Remy495/AMPED_UP/Website/Images/mechanical1.png

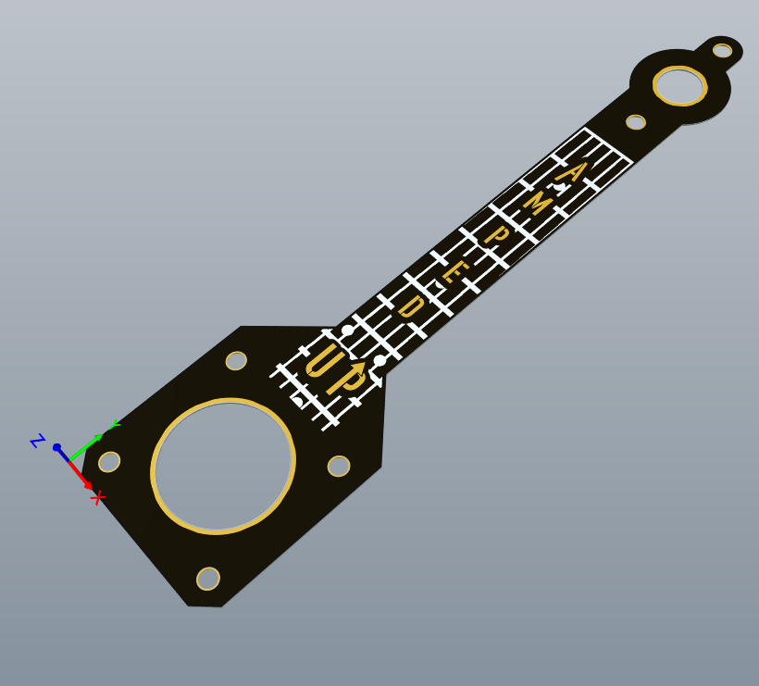
Website/Images/mechanical1.png
