Remy495/AMPED_UP/Website/Images/mechanical2.png

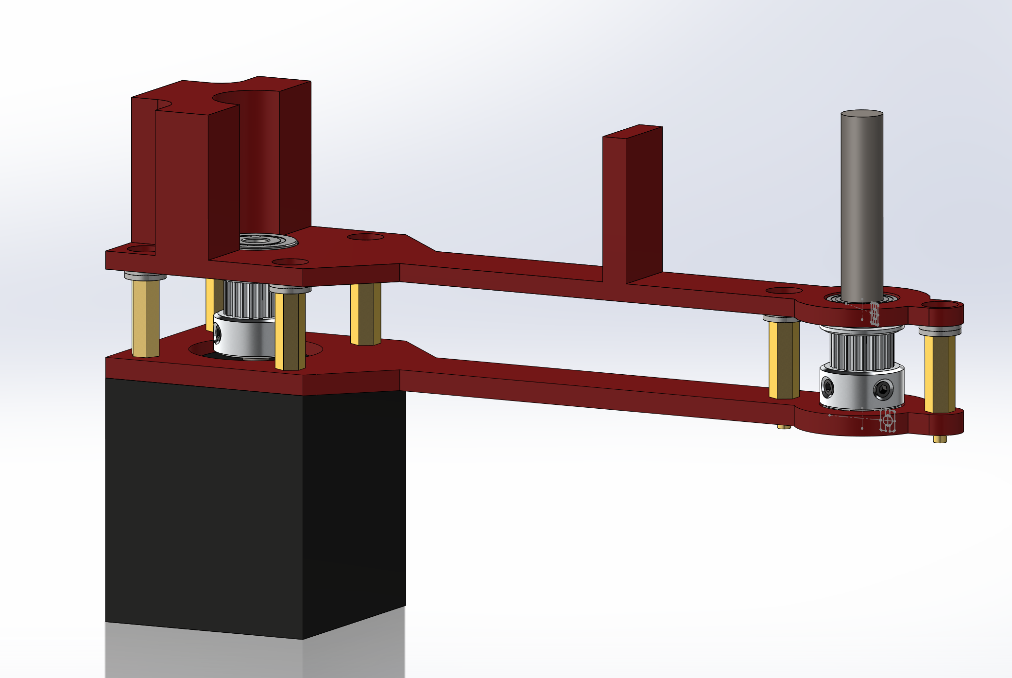
Website/Images/mechanical2.png
