Remy495/AMPED_UP/Website/Images/Aaron.jpg

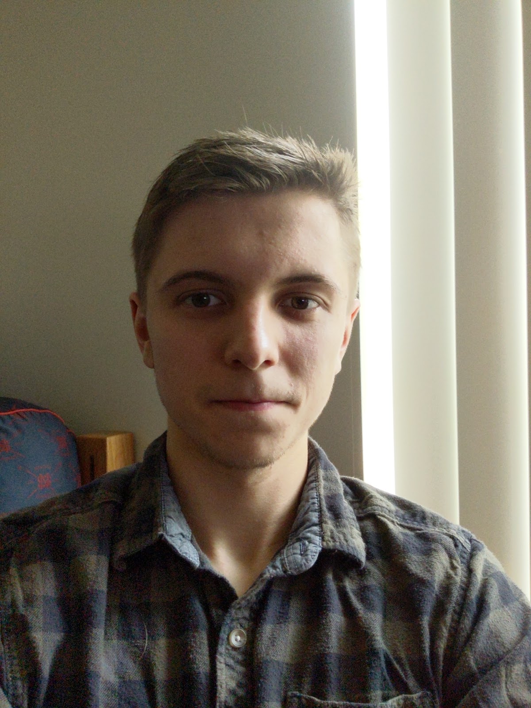
Website/Images/Aaron.jpg
