Remy495/AMPED_UP/Website/Images/Casey.jpg

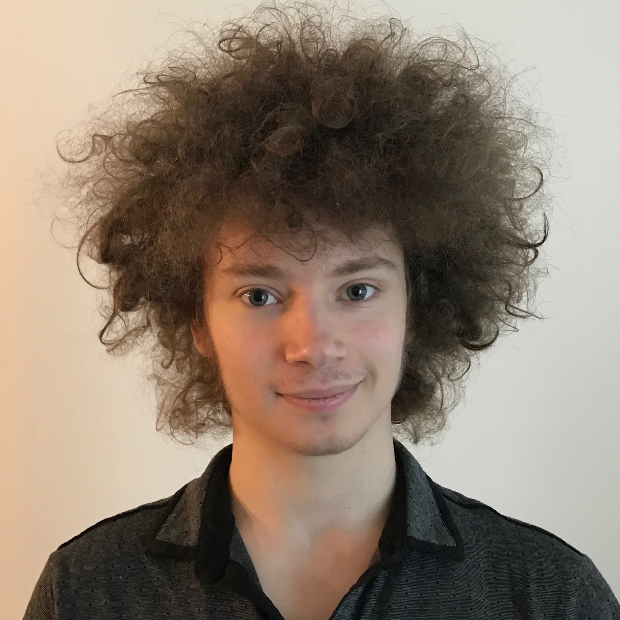
Website/Images/Casey.jpg
