Remy495/AMPED_UP/Website/Images/Chris.png

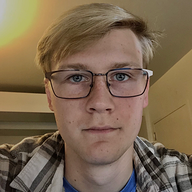
Website/Images/Chris.png
