Remy495/AMPED_UP/Website/Images/Design_Diagram.png

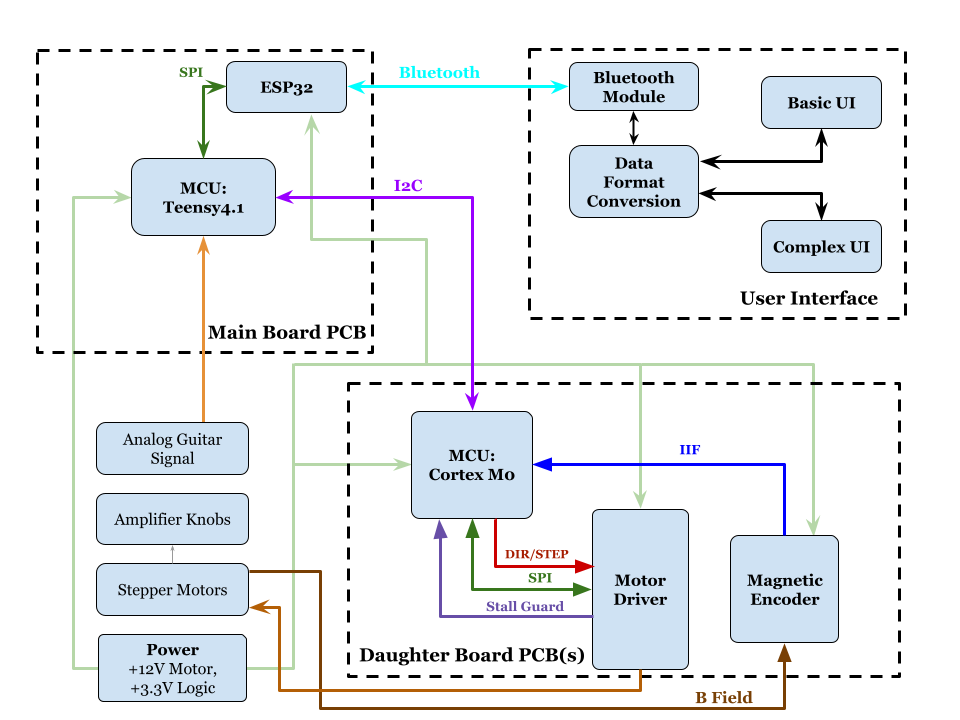
Website/Images/Design_Diagram.png
