Remy495/AMPED_UP/Website/Images/Mainboard.png

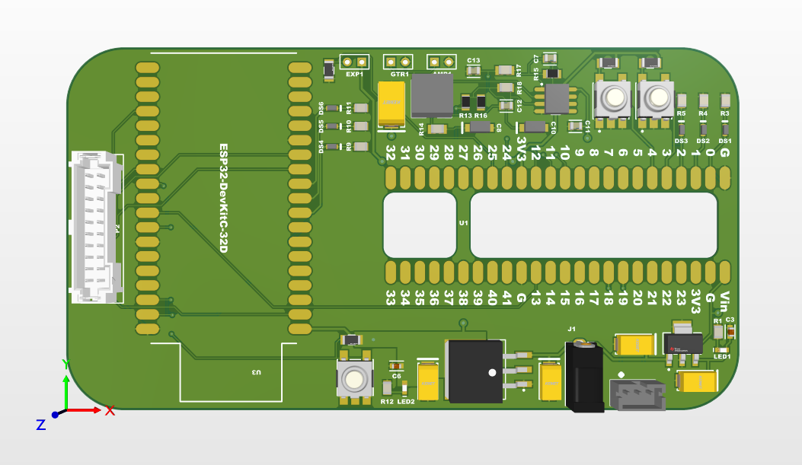
Website/Images/Mainboard.png
