Remy495/AMPED_UP/Website/Images/mechanical3.png

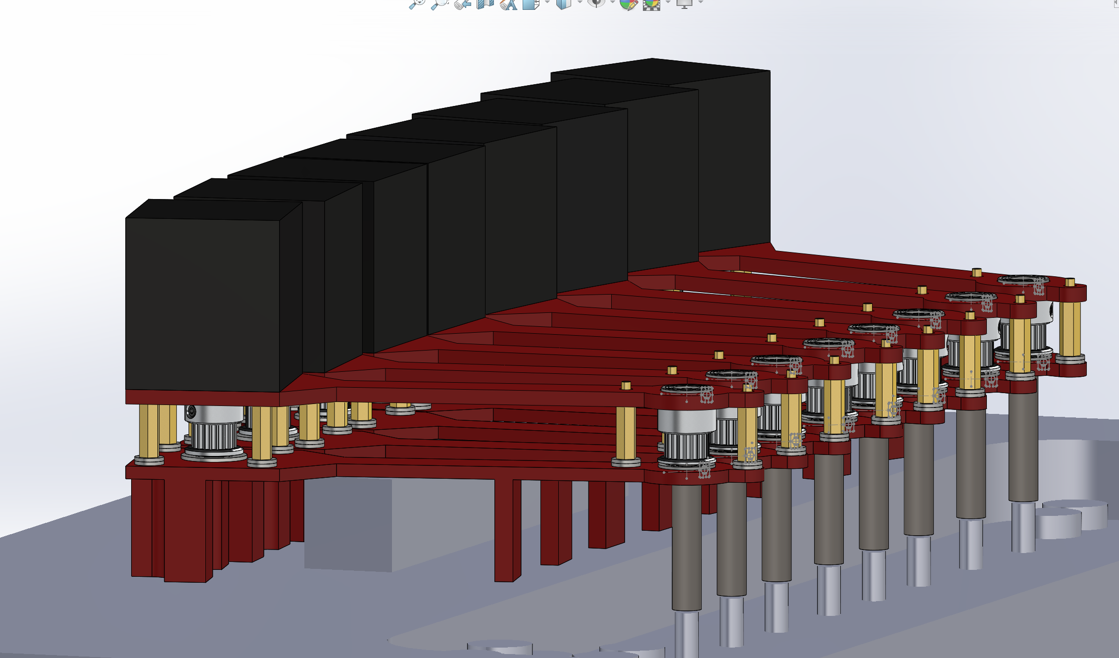
Website/Images/mechanical3.png
