Remy495/AMPED_UP/Website/Images/medium-ATSAMD21E15-TQFP-32.png

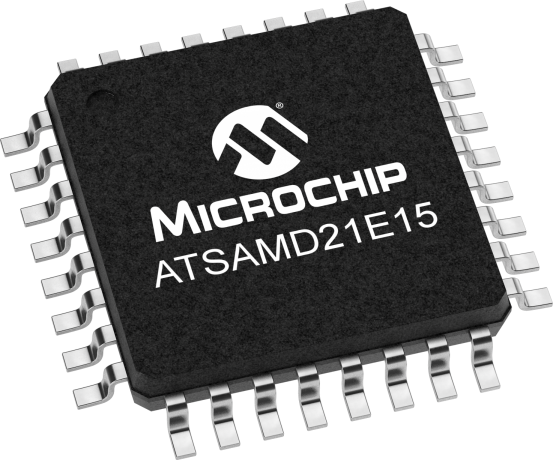
Website/Images/medium-ATSAMD21E15-TQFP-32.png
