Remy495/AMPED_UP/Website/Images/Remy.jpg

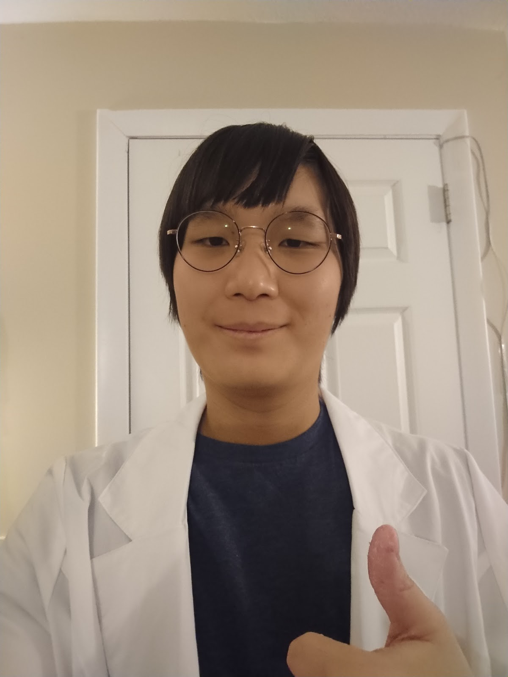
Website/Images/Remy.jpg
