Remy495/AMPED_UP/Website/Images/TLE5012B.jpg

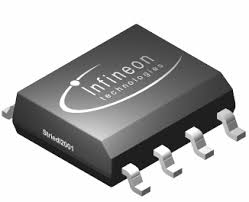
Website/Images/TLE5012B.jpg
