Remy495/AMPED_UP/Website/Images/TMC2130.jpg

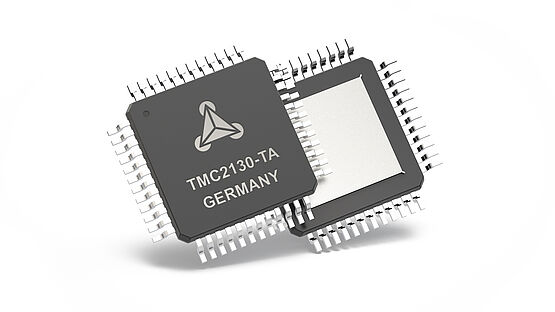
Website/Images/TMC2130.jpg
