Remy495/AMPED_UP/Website/Images/wolf.jpg

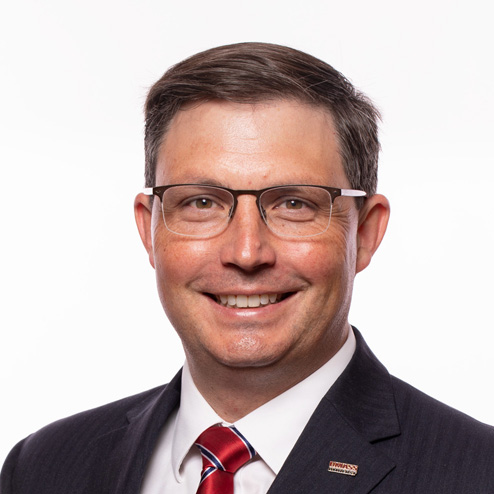
Website/Images/wolf.jpg
