Remy495/AMPED_UP/Altium/SDP21_Main_Board/SDP21_Main_Board_PCB.step

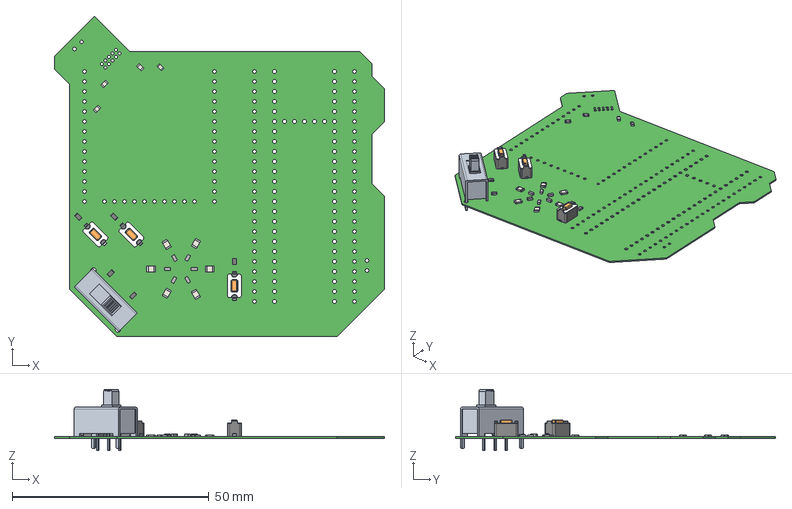
[picture p14: CAD file, 2020-11-20, an earlier design]
Altium/SDP21_Main_Board/SDP21_Main_Board_PCB.step
83.8 x 81.3 x 15.5 mm
Extruded x 36
c-1825255-1-a-3d
Frame x 3
Cover x 3
pins x 6
Mid_Body x 5
Open_CASCADE_STEP_translator_6.8_3.2.1 x 10
Mark x 5
