Remy495/AMPED_UP/Altium/SDP21_Daughter_Board/Project Outputs for SDP21_Daughter_Board/Job1.PDF

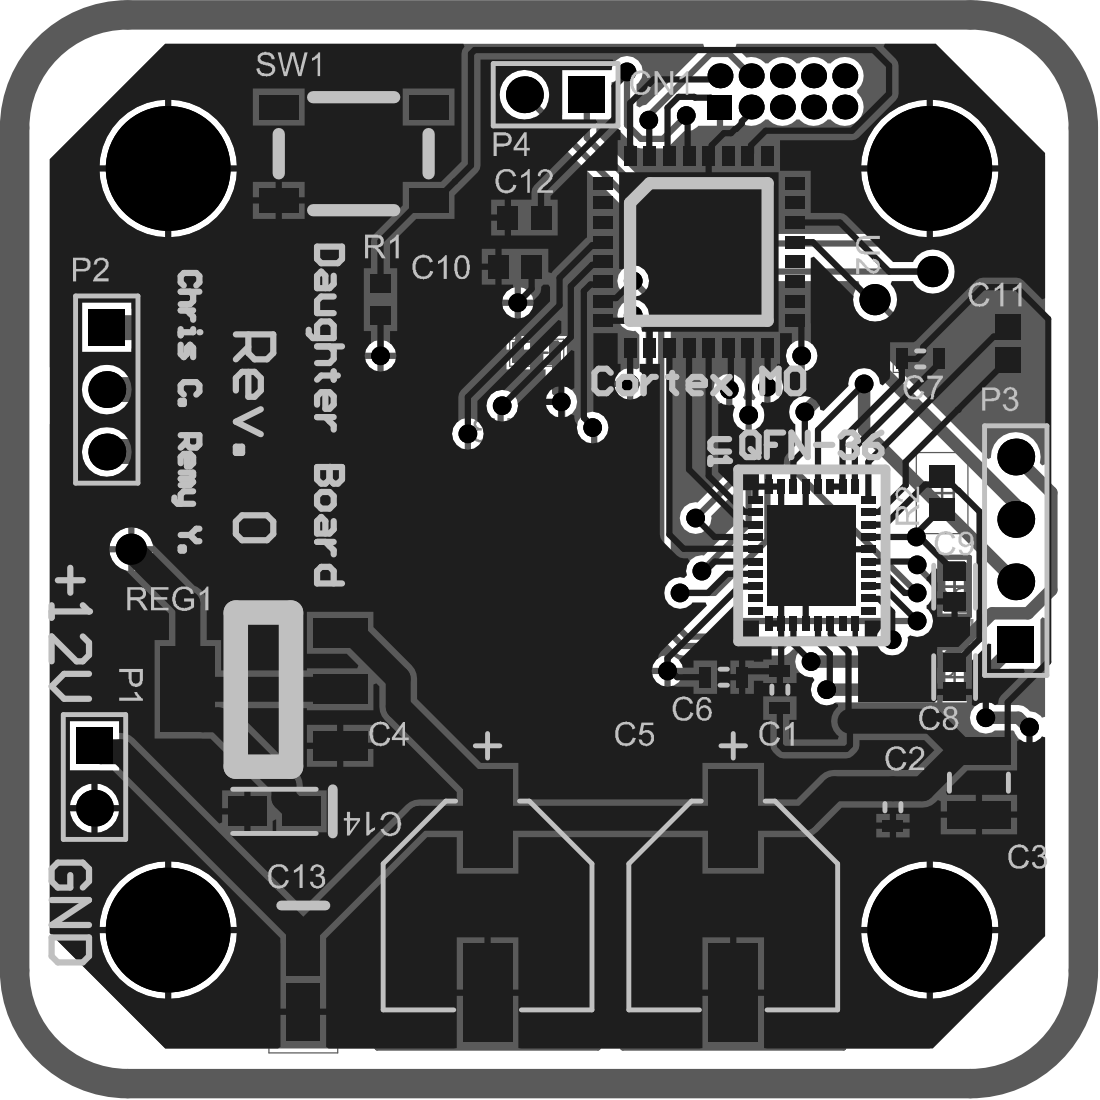
[picture p28: page 1]

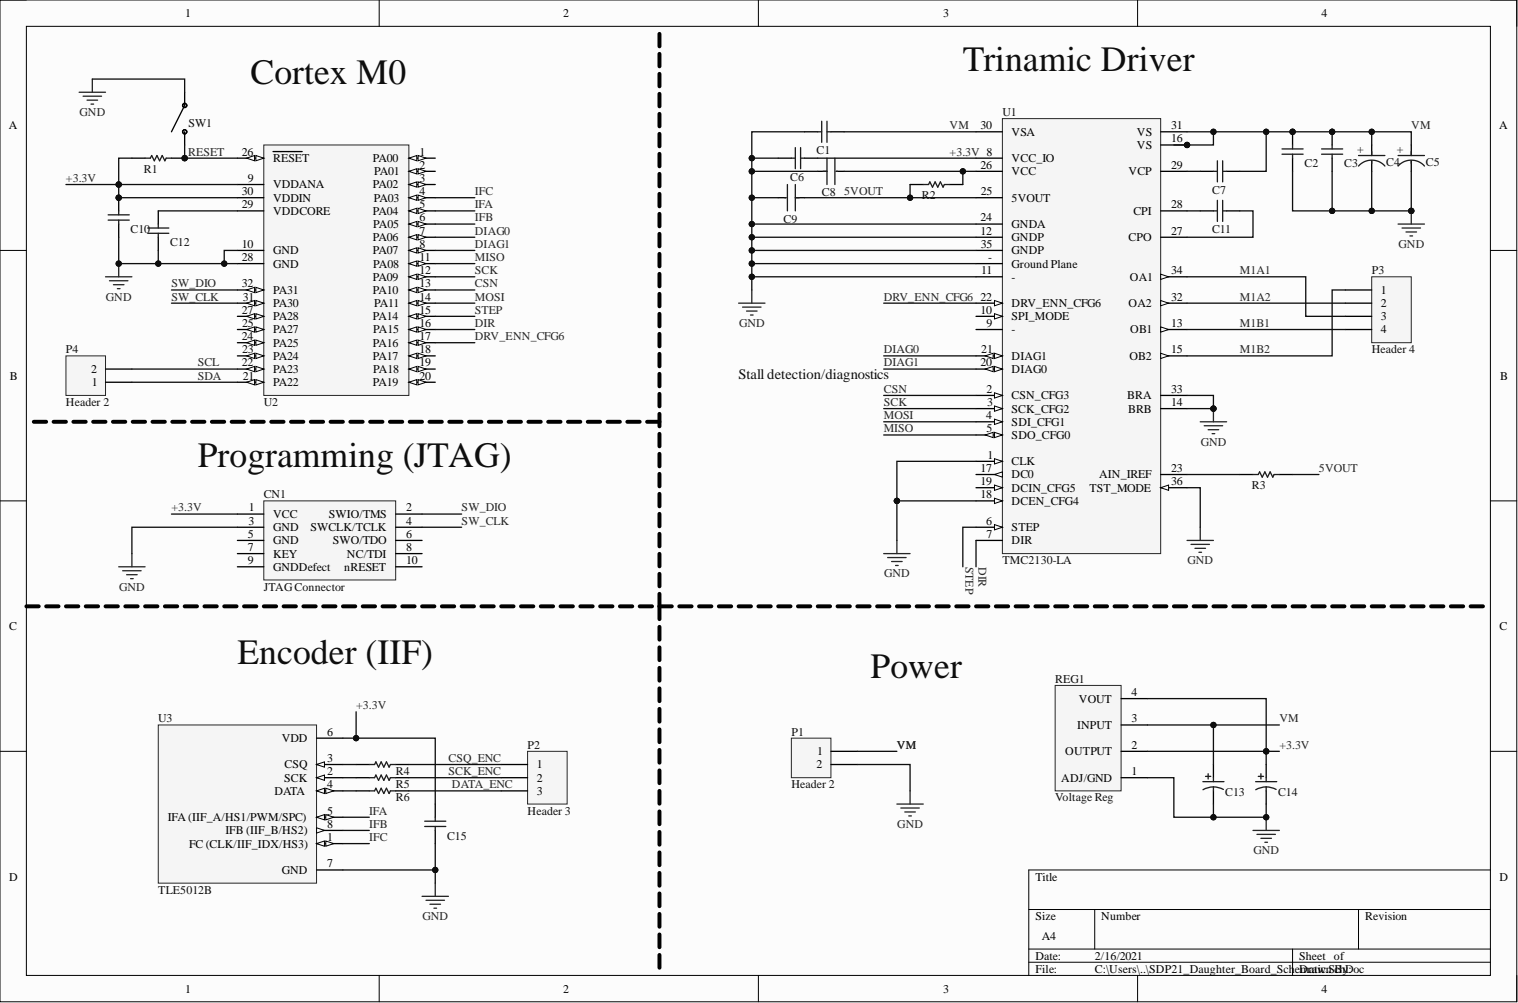
[picture p29: page 2]
