Remy495/AMPED_UP/(list of files, drawings)

Other design files:
Altium/Guitar_Input_Stage/Guitar Input PCB.PcbDoc
Altium/Guitar_Input_Stage/Guitar Input Schematic.SchDoc
Altium/Guitar_Input_Stage/SDP21_Guitar_Input_Stage.PrjPcb
Altium/Mechanical System/Mechanical Plates.PcbDoc
Altium/Mechanical System/Mechanical System.PrjPcb
Altium/PCB_Project/PCB_Project.PrjPcb
Altium/SDP21_Daughter_Board_REV1/Daughter_Board_PCB_Layout_REV1.PcbDoc
Altium/SDP21_Daughter_Board_REV1/SDP21_Daughter_Board_REV1.PrjPcb
Altium/SDP21_Daughter_Board_REV1/SDP21_Daughter_Board_Schematic_REV1.SchDoc
Altium/SDP21_Daughter_Board_REV1/SDP21_Footprints_REV1.PcbLib
Altium/SDP21_Daughter_Board_REV1/SDP21_Symbols_REV1.SchLib
Altium/SDP21_Guitar_Input_Stage/SDP21_Guitar Input PCB.PcbDoc
Altium/SDP21_Guitar_Input_Stage/SDP21_Guitar Input Schematic.SchDoc
Altium/SDP21_Guitar_Input_Stage/SDP21_Guitar_Input_Stage.PrjPcb
Altium/SDP21_Main_Board/SDP21_Daughter_Board_Footprints.PcbLib
Altium/SDP21_Main_Board/SDP21_Daughter_Board_Symbols.SchLib
Altium/SDP21_Main_Board/SDP21_Main_Board.PrjPcb
Altium/SDP21_Main_Board/SDP21_Main_Board_PCB.PcbDoc
Altium/SDP21_Main_Board/SDP21_Main_Board_PCB_Library.PcbLib
Altium/SDP21_Main_Board/SDP21_Main_Board_Schematic_Library.SchLib
Altium/SDP21_Main_Board_REV1/Main_Board_ESP32.SchDoc
Altium/SDP21_Main_Board_REV1/Main_Board_Guitar_Buffer.SchDoc
Altium/SDP21_Main_Board_REV1/Main_Board_IO.SchDoc
Altium/SDP21_Main_Board_REV1/Main_Board_PCB.PcbDoc
Altium/SDP21_Main_Board_REV1/Main_Board_Teensy.SchDoc
Altium/SDP21_Main_Board_REV1/SDP21_Main_Board_REV1.PrjPcb
Altium/SDP21_Trinamic_Driver_Board/SDP21_Footprints.PcbLib
Altium/SDP21_Trinamic_Driver_Board/SDP21_Trinamic_Driver_Board.PrjPcb
Altium/SDP21_Trinamic_Driver_Board/Trinamic Driver PCB.PcbDoc
Altium/SDP21_Trinamic_Driver_Board/Trinamic Driver Schematic.SchDoc
