Remy495/AMPED_UP/Hardware/Esp32/SpiRelay/main/main.cpp

/*
 * Copyright (C) 2020 BlueKitchen GmbH
 *
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
 * 1. Redistributions of source code must retain the above copyright
 *    notice, this list of conditions and the following disclaimer.
 * 2. Redistributions in binary form must reproduce the above copyright
 *    notice, this list of conditions and the following disclaimer in the
 *    documentation and/or other materials provided with the distribution.
 * 3. Neither the name of the copyright holders nor the names of
 *    contributors may be used to endorse or promote products derived
 *    from this software without specific prior written permission.
 *
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
 */

/*
 *  main.c
 *
 *  Minimal main application that initializes BTstack, prepares the example and enters BTstack's Run Loop.
 *
 *  If needed, you can create other threads. Please note that BTstack's API is not thread-safe and can only be
 *  called from BTstack timers or in response to its callbacks, e.g. packet handlers.
 */

#include "freertos/FreeRTOS.h"
#include "freertos/task.h"
#include "btstack_port_esp32.h"
#include "btstack_run_loop.h"
#include "hci_dump.h"

#include "BluetoothManager.hpp"
#include "SpiManager.hpp"

#include "CircularQueue.hpp"

#include <cstdio>
#include <iostream>
#include <stddef.h>

void runSpiManager(void*)
{
    if (!AmpedUp::SpiManager::run(GPIO_NUM_23, GPIO_NUM_19, GPIO_NUM_18, GPIO_NUM_22, GPIO_NUM_33))
    {
        printf("Error occured in SPI manager\n");
    }
}

TaskHandle_t spiTaskHandle = 0;

extern "C" int app_main(void){


    // Start SPI manager
    xTaskCreate(runSpiManager, "SpiManagerTask", 10240, nullptr, tskIDLE_PRIORITY, &spiTaskHandle);
    // Start Bluetooth manager
    AmpedUp::BluetoothManager::run();

    return 0;
}
