Remy495/AMPED_UP/Hardware/Cortex/C/M0_Motor_Test/driver_init.c

/*
 * Code generated from Atmel Start.
 *
 * This file will be overwritten when reconfiguring your Atmel Start project.
 * Please copy examples or other code you want to keep to a separate file
 * to avoid losing it when reconfiguring.
 */

#include "driver_init.h"
#include <peripheral_clk_config.h>
#include <utils.h>
#include <hal_init.h>
#include <hpl_gclk_base.h>
#include <hpl_pm_base.h>

#include <hpl_rtc_base.h>

struct spi_m_sync_descriptor SPI_0;
struct timer_descriptor      TIMER_0;

struct i2c_m_sync_desc I2C_0;

void SPI_0_PORT_init(void)
{

	// Set pin direction to input
	gpio_set_pin_direction(PA08, GPIO_DIRECTION_IN);

	gpio_set_pin_pull_mode(PA08,
	                       // <y> Pull configuration
	                       // <id> pad_pull_config
	                       // <GPIO_PULL_OFF"> Off
	                       // <GPIO_PULL_UP"> Pull-up
	                       // <GPIO_PULL_DOWN"> Pull-down
	                       GPIO_PULL_OFF);

	gpio_set_pin_function(PA08, PINMUX_PA08C_SERCOM0_PAD0);

	gpio_set_pin_level(PA09,
	                   // <y> Initial level
	                   // <id> pad_initial_level
	                   // <false"> Low
	                   // <true"> High
	                   false);

	// Set pin direction to output
	gpio_set_pin_direction(PA09, GPIO_DIRECTION_OUT);

	gpio_set_pin_function(PA09, PINMUX_PA09C_SERCOM0_PAD1);

	gpio_set_pin_level(PA11,
	                   // <y> Initial level
	                   // <id> pad_initial_level
	                   // <false"> Low
	                   // <true"> High
	                   false);

	// Set pin direction to output
	gpio_set_pin_direction(PA11, GPIO_DIRECTION_OUT);

	gpio_set_pin_function(PA11, PINMUX_PA11C_SERCOM0_PAD3);
}

void SPI_0_CLOCK_init(void)
{
	_pm_enable_bus_clock(PM_BUS_APBC, SERCOM0);
	_gclk_enable_channel(SERCOM0_GCLK_ID_CORE, CONF_GCLK_SERCOM0_CORE_SRC);
}

void SPI_0_init(void)
{
	SPI_0_CLOCK_init();
	spi_m_sync_init(&SPI_0, SERCOM0);
	spi_m_sync_set_mode(&SPI_0, SPI_MODE_3);
	SPI_0_PORT_init();
}

void I2C_0_PORT_init(void)
{

	gpio_set_pin_pull_mode(PA22,
	                       // <y> Pull configuration
	                       // <id> pad_pull_config
	                       // <GPIO_PULL_OFF"> Off
	                       // <GPIO_PULL_UP"> Pull-up
	                       // <GPIO_PULL_DOWN"> Pull-down
	                       GPIO_PULL_OFF);

	gpio_set_pin_function(PA22, PINMUX_PA22C_SERCOM3_PAD0);

	gpio_set_pin_pull_mode(PA23,
	                       // <y> Pull configuration
	                       // <id> pad_pull_config
	                       // <GPIO_PULL_OFF"> Off
	                       // <GPIO_PULL_UP"> Pull-up
	                       // <GPIO_PULL_DOWN"> Pull-down
	                       GPIO_PULL_OFF);

	gpio_set_pin_function(PA23, PINMUX_PA23C_SERCOM3_PAD1);
}

void I2C_0_CLOCK_init(void)
{
	_pm_enable_bus_clock(PM_BUS_APBC, SERCOM3);
	_gclk_enable_channel(SERCOM3_GCLK_ID_CORE, CONF_GCLK_SERCOM3_CORE_SRC);
	_gclk_enable_channel(SERCOM3_GCLK_ID_SLOW, CONF_GCLK_SERCOM3_SLOW_SRC);
}

void I2C_0_init(void)
{
	I2C_0_CLOCK_init();
	i2c_m_sync_init(&I2C_0, SERCOM3);
	I2C_0_PORT_init();
}

/**
 * \brief Timer initialization function
 *
 * Enables Timer peripheral, clocks and initializes Timer driver
 */
static void TIMER_0_init(void)
{
	_pm_enable_bus_clock(PM_BUS_APBA, RTC);
	_gclk_enable_channel(RTC_GCLK_ID, CONF_GCLK_RTC_SRC);
	timer_init(&TIMER_0, RTC, _rtc_get_timer());
}

void system_init(void)
{
	init_mcu();

	SPI_0_init();

	I2C_0_init();

	TIMER_0_init();
}
