Remy495/AMPED_UP/(commit log)

2020-10-12 Project Begin
    Created first project docs
    [SDP21_Daughter_Board.PrjPcb, SDP21_Daughter_Board_Schematic.SchDoc, SDP21_Footprints.PcbLib, SDP21_Symbols.SchLib]
2020-10-13 Added Symbols and Footprints
    Added custom footprints and symbols for encoder, stepper driver and Cortex M0 MCU
    [SDP21_Footprints.PcbLib, SDP21_Symbols.SchLib]
2020-10-13 Continued Work
    Need to add schematic elements with appropriate supposrting hardware before connecting encoder and driver to MCU
    [SDP21_Daughter_Board_Schematic.SchDoc, SDP21_Symbols.SchLib]
2020-10-14 Finished .Preparing TMC
    yeah.
    [SDP21_Daughter_Board_Schematic.SchDoc]
2020-10-15 Continued Development
    [SDP21_Daughter_Board_Schematic.SchDoc, SDP21_Footprints.PcbLib, SDP21_Symbols.SchLib]
2020-10-16 progress
    made progress
    [SDP21_Daughter_Board_Schematic.SchDoc, SDP21_Footprints.PcbLib, SDP21_Symbols.SchLib]
2020-10-16 Progress
    ...
    [SDP21_Daughter_Board_Schematic.SchDoc]
2020-10-16 Testing something
    yeah
    [SDP21_Daughter_Board_Schematic.SchDoc]
2020-10-16 Guthub Testing
    ignore
    [SDP21_Daughter_Board_Schematic.SchDoc]
2020-10-16 Finished Com Lines
    Just need to wire the JTAG connector
    [SDP21_Footprints.PcbLib, SDP21_Symbols.SchLib]
2020-10-20 Fixed M0 Pin Connections
    Still need programmer and stuff
    [SDP21_Daughter_Board_Schematic.SchDoc]
2020-10-20 Preparing for Checkin
    Need to fix JTAG and also doble check connections before layout
    [SDP21_Daughter_Board_Schematic.SchDoc]
2020-10-20 Hey I made a PCB outline
    Lol this will be fun to route....
    [Daughter_Board_PCB_Layout.PcbDoc, SDP21_Daughter_Board.PrjPcb, SDP21_Daughter_Board_Schematic.SchDoc, SDP21_Symbols.SchLib]
2020-10-21 Crappy PCB Layout
    Needs a lot of work before routing can start. Why is R6 a different footprint??
    [Daughter_Board_PCB_Layout.PcbDoc, SDP21_Daughter_Board_Schematic.SchDoc]
2020-10-21 small changes
    I keep messing with it lol
    [Daughter_Board_PCB_Layout.PcbDoc]
2020-10-23 PCB part placement
    [Daughter_Board_PCB_Layout.PcbDoc, SDP21_Daughter_Board.PrjPcb, SDP21_Daughter_Board_Schematic.SchDoc]
2020-10-23 Routing begin.
    [Daughter_Board_PCB_Layout.PcbDoc, SDP21_Daughter_Board_Schematic.SchDoc, SDP21_Footprints.PcbLib]
2020-10-23 tracing done. Pour
    [Daughter_Board_PCB_Layout.PcbDoc]
2020-10-23 Cleared rule check error
    [Daughter_Board_PCB_Layout.PcbDoc]
2020-10-23 Added C++ Makefile for Teensy
2020-10-27 Fixed Mech1 Issues
    Should be ready to send out for V1
    [Daughter_Board_PCB_Layout.PcbDoc, PCB1.PcbDoc, PCB_Project.PrjPcb, SDP21_Footprints.PcbLib, Sheet1.SchDoc]
2020-10-27 bug fix
    polygon thin line bug fix
    [Daughter_Board_PCB_Layout.PcbDoc, SDP21_Daughter_Board.PrjPcb]
2020-11-04 Main Board Start!
    Updated and organized files/folders. Created Main board project, Schematic, SchLib, PCBLib. Created Symbols and footprints for Teensy socket and Espressif ESP-32. Should be ready to start wiring up this mainboard!
    [SDP21_Main_Board.PrjPcb, SDP21_Main_Board_PCB_Library.PcbLib, SDP21_Main_Board_Schematic.SchDoc, SDP21_Main_Board_Schematic_Library.SchLib]
2020-11-09 Main Board Signal Routing
    Need to take care of + and GND pours still, but most signal routing is finished
    [SDP21_Daughter_Board_Footprints.PcbLib, SDP21_Daughter_Board_Symbols.SchLib, SDP21_Main_Board.PrjPcb, SDP21_Main_Board_PCB.PcbDoc, SDP21_Main_Board_PCB_Library.PcbLib, SDP21_Main_Board_Schematic.SchDoc, SDP21_Main_Board_Schematic_Library.SchLib]
2020-11-10 Minor Formatting
    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
    [SDP21_Main_Board_PCB.PcbDoc]
2020-11-10 Minor Changes
    [SDP21_Daughter_Board_Schematic.SchDoc, SDP21_Main_Board_PCB.PcbDoc]
2020-11-10 Main Board PCB Finished!
    Finished routing, pours, DRC, Gerber/NC Drill creation. Began ActiveBOM but gave up.
    [Altium BOM Output - not completed.csv, SDP21_Main_Board.PrjPcb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]
2020-11-10 Syncing Files
    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
    [SDP21_Main_Board_PCB.PcbDoc]
2020-11-12 Made Trinamic Driver Dev Board
    Started dev board for these weird drivers. Needs final routing and rule check.
    [SDP21_Daughter_Board.PrjPcb, SDP21_Footprints.PcbLib, SDP21_Symbols.SchLib, SDP21_Trinamic_Driver_Board.PrjPcb, Trinamic Driver PCB.PcbDoc, Trinamic Driver Schematic.SchDoc]
2020-11-14 Created Flatbuffers schema for communication between the remote GUI and the Teensy
2020-11-14 Created basic framework for running node graph on the Teensy
2020-11-15 Syncing Changes
    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
    [Daughter_Board_PCB_Layout.PcbDoc, SDP21_Main_Board_PCB.PcbDoc]
2020-11-16 Sync
    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
    [SDP21_Main_Board.PrjPcb, SDP21_Main_Board_PCB.PcbDoc]
2020-11-17 TMC Breakout Board Finished
    [SDP21_Trinamic_Driver_Board.PrjPcb, Trinamic Driver PCB.PcbDoc, Trinamic Driver Schematic.SchDoc]
2020-11-17 silkscreen added to breakout board
    [Trinamic Driver PCB.PcbDoc]
2020-11-17 Trinamic Breakout Done
    yes
    [SDP21_Footprints.PcbLib, SDP21_Trinamic_Driver_Board.PrjPcb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]
2020-11-17 Corrected Error and Remade Outputs
    Grounded breakout pin 11 and remade Gerber
    [SDP21_Trinamic_Driver_Board.PrjPcb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]
2020-11-20 Main Board 3D export experiment
    trying to render the main board in blender for fun
    [SDP21_Main_Board_PCB.step, SDP21_Trinamic_Driver_Board.PrjPcb]
2020-11-21 Added Arduino and C Files From MDR
    [M0_Motor_Test.componentinfo.xml]
2021-01-07 Sync
    Syncing Files
    [Custom Component Tutorial.PrjPcb, PCB1.PcbDoc, Schematic Symbol Tutorial.SchLib, Sheet1.SchDoc, Test Sheet.SchDoc, Tutorial PCB Library.PcbLib]
2021-01-07 Accidentally Uploaded Files
    oops
    [Custom Component Tutorial.PrjPcb, PCB1.PcbDoc, Schematic Symbol Tutorial.SchLib, Test Sheet.SchDoc, Tutorial PCB Library.PcbLib]
2021-01-28 Slight Changes
    Formatting changes prior to customer support submission, project packaging.
    [SDP21_Trinamic_Driver_Board.PrjPcb, Trinamic Driver Schematic.SchDoc]
2021-01-28 Removed 3.3 Res
    [Trinamic Driver PCB.PcbDoc]
2021-02-05 Add Guitar Input Stage
    First Version of Guitar Input Stage
    [Guitar Input PCB.PcbDoc, Guitar Input Schematic.SchDoc, Guitar_Input_Stage.PrjPcb]
2021-02-05 Daughter Board Rev1
    Began new daughterboard file
    [Daughter_Board_PCB_Layout_REV1.PcbDoc, Guitar Input PCB.PcbDoc, Guitar Input Schematic.SchDoc, Guitar_Input_Stage.PrjPcb, SDP21_Daughter_Board_REV1.PrjPcb, SDP21_Daughter_Board_Schematic_REV1.SchDoc, SDP21_Footprints_REV1.PcbLib, SDP21_Symbols_REV1.SchLib]
2021-02-05 File Name Adjustments
    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
    [SDP21_Guitar Input PCB.PcbDoc, SDP21_Guitar Input Schematic.SchDoc, SDP21_Guitar_Input_Stage.PrjPcb]
2021-02-05 More File Adjustments
    ignore again
    [Guitar Input PCB.PcbDoc, Guitar Input Schematic.SchDoc, SDP21_Daughter_Board_REV1.PrjPcb, SDP21_Guitar_Input_Stage.PrjPcb]
2021-02-08 Started Daughter Board V2
    mostly schematic stuff
    [Daughter_Board_PCB_Layout_REV1.PcbDoc, SDP21_Daughter_Board_REV1.PrjPcb, SDP21_Daughter_Board_Schematic_REV1.SchDoc]
2021-02-08 quick maths
    [SDP21_Daughter_Board_Schematic_REV1.SchDoc]
2021-02-08 Create FullTrinamic.ino
    Added Arduino Files That Implement Control of the Trinamic Driver iincorporating both step/dir and SPI control(2/8: SPI control is still non functioning, contacting customer support for more info)
2021-02-08 Update main.c
    Small changes to M0 Motor Driving code
2021-02-09 Initial Component Layout
    Started laying out components. Need to switch to 4 layers
    [Daughter_Board_PCB_Layout_REV1.PcbDoc, SDP21_Daughter_Board_Schematic_REV1.SchDoc]
2021-02-09 Component Placement and Routing
    [Daughter_Board_PCB_Layout_REV1.PcbDoc, SDP21_Daughter_Board_REV1.PrjPcb, SDP21_Daughter_Board_Schematic_REV1.SchDoc]
2021-02-09 Slightly More Routing Progress
    [Daughter_Board_PCB_Layout_REV1.PcbDoc]
2021-02-17 output pdf
    [SDP21_Daughter_Board_REV1.PrjPcb, SDP21_Main_Board.PrjPcb]
2021-02-19 Created framework for I2C communication on cortex M0
2021-02-19 Moved teensy code into build tools, added latest compiler toolchain to repository to avoid needing to install it everywhere
    [Main.cpp]
2021-02-23 Added Lots of Trinamic Driver Control Information and Programming
2021-02-24 Routing Changes
    [Daughter_Board_PCB_Layout_REV1.PcbDoc, SDP21_Daughter_Board_Schematic_REV1.SchDoc]
2021-02-24 ready to ship?
    [Daughter_Board_PCB_Layout_REV1.PcbDoc]
2021-02-26 Finished Daughter Board Rev1
    [Daughter_Board_PCB_Layout_REV1.PcbDoc, SDP21_Daughter_Board_REV1.PrjPcb]
2021-02-26 More Work on getting the SPI interface working for the M0
2021-02-26 Began ActiveBOM
    [Daughter_Board_PCB_Layout_REV1.PcbDoc, SDP21_Daughter_Board_REV1.PrjPcb]
2021-02-26 Unshelved pours
    [Daughter_Board_PCB_Layout_REV1.PcbDoc]
2021-02-26 Finished and Uploaded to JLC
    [Daughter_Board_PCB_Layout_REV1.GBL, Daughter_Board_PCB_Layout_REV1.GBO, Daughter_Board_PCB_Layout_REV1.GBP, Daughter_Board_PCB_Layout_REV1.GBS, Daughter_Board_PCB_Layout_REV1.GM1, Daughter_Board_PCB_Layout_REV1.GTL, Daughter_Board_PCB_Layout_REV1.GTO, Daughter_Board_PCB_Layout_REV1.GTP]
2021-02-26 BOM development
    [Daughter_Board_PCB_Layout_REV1.PcbDoc]
2021-02-26 Even More updated SPI stuff :)
2021-02-26 Added Website Folder with all current work done on website
2021-02-27 Reset switch revision and BOM dev
    [Daughter_Board_PCB_Layout_REV1.GBL, Daughter_Board_PCB_Layout_REV1.GBO, Daughter_Board_PCB_Layout_REV1.GBP, Daughter_Board_PCB_Layout_REV1.GBS, Daughter_Board_PCB_Layout_REV1.GM1, Daughter_Board_PCB_Layout_REV1.GTL, Daughter_Board_PCB_Layout_REV1.GTO, Daughter_Board_PCB_Layout_REV1.GTP]
2021-02-27 Finished BOM and Board
2021-03-03 Added Website Changes as well as some small Motor Stuff(Still no SPI!!!)
2021-03-05 Created I2C message server for Teensy, updated I2C communication to use simple checksum, created C wrapper for SercomInterface on M0
2021-03-05 Small changes to SPI code
2021-03-05 Made Main Board REV1 Project
    [Main_Board_ESP32.SchDoc, Main_Board_IO.SchDoc, Main_Board_Teensy.SchDoc, SDP21_Main_Board_REV1.PrjPcb]
2021-03-08 Created Main Board PCB
    [Main_Board_ESP32.SchDoc, Main_Board_IO.SchDoc, Main_Board_PCB.PcbDoc, Main_Board_Teensy.SchDoc, SDP21_Daughter_Board_REV1.PrjPcb, SDP21_Main_Board_PCB_Library.PcbLib, SDP21_Main_Board_REV1.PrjPcb, SDP21_Main_Board_Schematic.SchDoc]
2021-03-09 Slight Board Shape Adjustments
    [Main_Board_PCB.PcbDoc, SDP21_Main_Board.PrjPcb]
2021-03-11 Main Board PCB Layout
    Preliminary Layout for Mainboard PCB. Needs work on ESP32 schematic
    [Main_Board_ESP32.SchDoc, Main_Board_Guitar_Buffer.SchDoc, Main_Board_IO.SchDoc, Main_Board_PCB.PcbDoc, SDP21_Main_Board_PCB_Library.PcbLib, SDP21_Main_Board_REV1.PrjPcb, SDP21_Main_Board_Schematic_Library.SchLib]
2021-03-12 Preliminary Main board routing
    [Main_Board_Guitar_Buffer.SchDoc, Main_Board_PCB.PcbDoc]
2021-03-13 Added All Required Code for the 3/13 Daughterboard PCB test
2021-03-16 Created Mechanical Board
    [Main_Board_PCB.PcbDoc, Mechanical Plates.PcbDoc, Mechanical System.PrjPcb]
2021-03-16 esp32 edit
    [Main_Board_ESP32.SchDoc]
2021-03-16 Finished Mech Component
    [Mechanical Plates.GBL, Mechanical Plates.GBO, Mechanical Plates.GBP, Mechanical Plates.GBS, Mechanical Plates.GM1, Mechanical Plates.GTL, Mechanical Plates.GTO, Mechanical Plates.GTS]
2021-03-16 Main Board Routing
    [Main_Board_ESP32.SchDoc, Main_Board_PCB.PcbDoc]
2021-03-21 Finished Main Board Routing
    [Main_Board_ESP32.SchDoc, Main_Board_Guitar_Buffer.SchDoc, Main_Board_IO.SchDoc, Main_Board_PCB.PcbDoc, Main_Board_Teensy.SchDoc, SDP21_Main_Board_REV1.PrjPcb]
2021-03-21 Cleared Mainboard DRC
    [Main_Board_PCB.PcbDoc, SDP21_Main_Board_REV1.PrjPcb]
2021-03-21 Fixed Main Board
    [Main_Board_PCB.PcbDoc]
2021-03-22 mainboard check
    [Main_Board_ESP32.SchDoc, Main_Board_IO.SchDoc, Main_Board_Teensy.SchDoc]
2021-03-24 mainboard routed
    [Main_Board_ESP32.SchDoc, Main_Board_IO.SchDoc, Main_Board_PCB.PcbDoc, Main_Board_Teensy.SchDoc, SDP21_Main_Board_REV1.PrjPcb]
2021-03-26 Exported Main Board Gerbers
    Oh God i hope this board isnt screwed up
    [Main_Board_PCB.GBL, Main_Board_PCB.GBO, Main_Board_PCB.GBP, Main_Board_PCB.GBS, Main_Board_PCB.GM1, Main_Board_PCB.GTL, Main_Board_PCB.GTO, Main_Board_PCB.GTP]
2021-03-29 Added the SPI testing project from my local directory. It is the iteration of the project that uses no atmel start packages
2021-03-31 Added External Interrupt Support for the Magnetic Encoder
2021-04-02 mainboatd BOM
    [SDP21_Main_Board_REV1.PrjPcb]
2021-04-04 Implemented extremely basic bluetooth relay for the Teensy on the ESP32
2021-04-13 Added Intital Testing for Encoder Based Stall Detection
    [Timing.h, main.c]
2021-04-13 More Encoder Stall Detection(Still In Progress)
    [main.c]
2021-04-13 Implemented simple messaging protocol over SPI between Teensy and ESP32, refined implementation of Bluetooth-SPI relay
2021-04-13 Fully Working Stall Detection Utilizing Magnetic Encoder
    [main.c]
2021-04-15 Improvements and bugfixes to bluetooth relay
    [Main.cpp, SpiManager.cpp, SpiMessager.hpp, Time.cpp, Time.hpp]
2021-04-16 Performance improvements to bluetooth relay
2021-04-17 Encoder Fixes, Stall Detection, And Dip switch functionality
    [Timing.h, main.c]
2021-04-17 Added I2C Messenger to DB code
2021-04-17 Fixed a bug where the I2C code for the cortex grabbed all of the Sercom interrupts
2021-04-17 Multiple Modes of Angle Control: Encoder and Step based
2021-04-21 Fixed strange, esoteric bug with the way the Cortex I2C library was linked
    [MainBoardMessager.h]
2021-04-26 Added minor improvements to stall detection
    [Timing.h, main.c]
2021-04-28 Added two levels of step speed increment to make acceloration more linear, minor improvements to stall detection
    [main.c]
2021-04-28 Reverted Amped-Up-DB-Control-Program to fix bug
    [MainBoardMessager.h, Pins.h, Pins_Setup.h, SercomConfig.h, SercomSetup.h, TempSPI.h, Timing.h, main.c]
2021-04-29 Implemented audio processing on Teensy
2021-05-05 Fixed a bug that caused the knob to turn to the wrong position when manual override finishes
    [main.c]
